ZalophusDokdo/eX-Robot-ESP/images/ESP8266_ESP-12E_WeMos_D1_mini_eX-Robot_Photo_20170421_0028.jpg

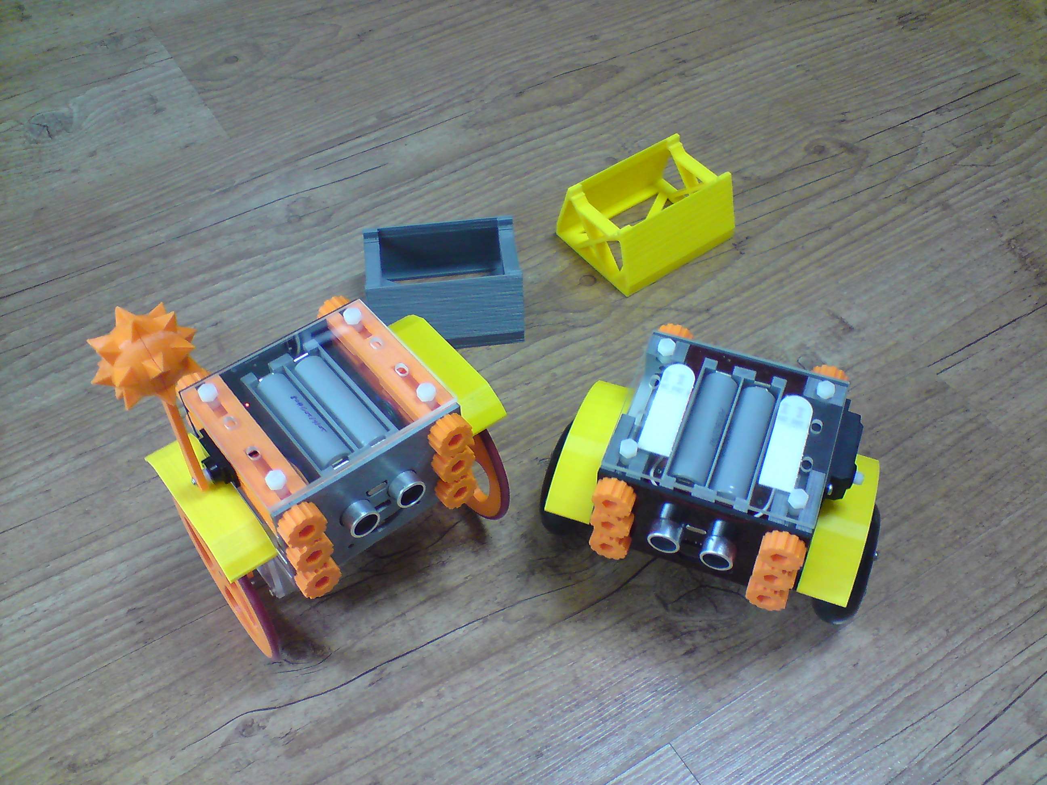
images/ESP8266_ESP-12E_WeMos_D1_mini_eX-Robot_Photo_20170421_0028.jpg
