ZalophusDokdo/eX-Robot-ESP/images/ESP8266_ESP-12E_WeMos_D1_mini_eX-Robot_Photo_20171026_4979.JPG

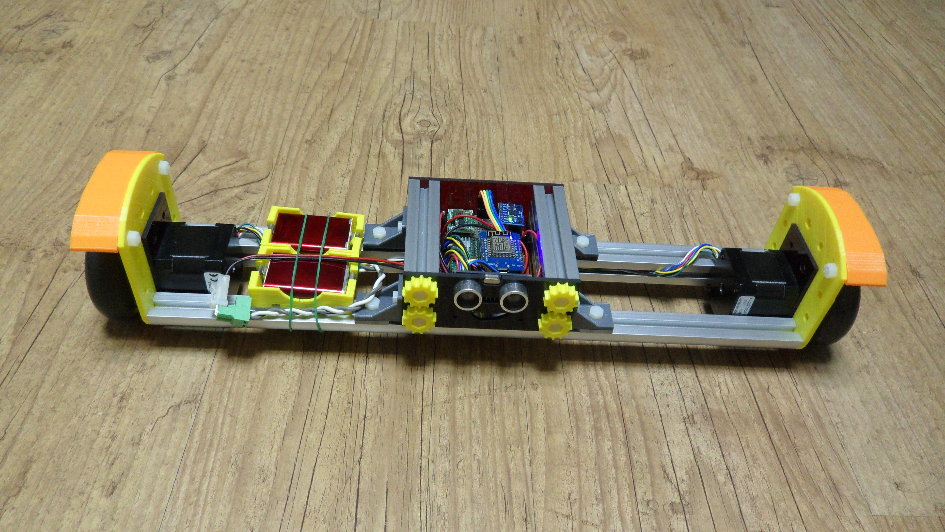
images/ESP8266_ESP-12E_WeMos_D1_mini_eX-Robot_Photo_20171026_4979.JPG
